argusro/Wearable_Datalogger/hardware/BOM_Wearable_ESP32-Pico.csv

ID | Name | Designator | Footprint | Quantity | Manufacturer Part | Manufacturer
1 | GPS1003 | ANT | ANT-SMD_L10.0-W3.0 | 1 | GPS1003 | Rainsun microwave Tech
2 | WF12502-01200 | BAT | CONN-SMD_2P-P1.25_L4.4-W7.5 | 1 | WF12502-01200 | SHENZHEN ATOM TECH
3 | 100nF | C1,C3,C4,C5,C8 | C0402 | 5 | CC0402KRX5R7BB104 | YAGEO
4 | 10uF | C2 | C0402 | 1 | CC0402MRX5R5BB106 | YAGEO
5 | 10uF | C6 | C0402 | 1 | 0402X105K100NT | FH
6 | 1uF | C7 | C0402 | 1 | 0402X105K100NT | FH
7 | 100nF | C9,C11 | C1206 | 2 | CC0402KRX5R7BB104 | YAGEO
8 | 80mF | C10 | CAP-TH_XH414HG | 1 | XH414HG-IV01E | SEIKO
9 | SD103CWS S6 | D1 | SOD-323_L1.8-W1.3-LS2.5-RD | 1 | SD103CWS S6 | CJ
10 | ESP32-PICO-V3 | ESP | LGA-48_L7.0-W7.0-P0.50-BL-EP5.0 | 1 | ESP32-PICO-V3 | ESPRESSIF
12 | 27uH | L1 | L0603 | 1 | SDFL1608T270KTF | Sunlord
13 | 19-213/R7C-AP1Q2L/3T | LED1 | LED0603-R-RD | 1 | 19-213/R7C-AP1Q2L/3T | Everlight Elec
14 | 19-217/G7C-BK2L2VY/3T | LED2,LED3 | LED0603-R-RD | 2 | 19-217/G7C-BK2L2VY/3T | Everlight Elec
15 | FS8205 | Q3 | SOT-23-6 | 1 | FS8205 | FORTUNE
16 | 10K | R1,R2,R9,R10,R11,R12,R13,R17,R18,R19,R20,R21,R24 | R0402 | 13 | RC0402JR-0710KL | YAGEO
17 | 1.2K | R3 | R0402 | 1 | CR0402-JW-122GLF | BOURNS
18 | 1K | R4 | R0402 | 1 | AC0402JR-071KL | YAGEO
19 | 100R | R5 | R0402 | 1 | AECR0402F100RK9 | ResistorToday
20 | 750K | R6 | R0402 | 1 | RC0402FR-07750KL | YAGEO
21 | 220K | R7 | R0402 | 1 | RMC0402220K1%N | Tyohm
22 | 33R | R8,R14,R15,R16 | R0402 | 4 | RC0402JR-0710KL | YAGEO
23 | 22R | R22 | R0402 | 1 | RC0402JR-0710KL | YAGEO
24 | 1K | R23 | R0402 | 1 | RC0402JR-0710KL | YAGEO
25 | 10k | R25,R26,R27,R28 | R0402 | 4 | RC0402JR-0710KL | YAGEO
26 | U.FL-R-SMT(10) | RF1 | ANT-SMD_UFL-R-SMT | 1 | U.FL-R-SMT(10) | Hirose
27 | sd | SD | TF-SMD_TF-012 | 1 | TF-CARD-ETF010811020008X | null
28 | TS342A2P-WZ | SW1 | SW-SMD_L4.0-W2.9-LS5.0 | 1 | TS342A2P-WZ | SHOU HAN
29 | BME280 | U2 | LGA-8_BME280 | 1 | BME280 | Bosch
30 | MPU-9250 | U3 | ICM-20948 | 1 | MPU-9250 | InvenSense
31 | TP4056 | U4 | ESOP-8_L4.9-W3.9-P1.27-LS6.0-BL-EP | 1 | TP4056 | TOPPOWER
32 | 24AA32A-I/SN | U5 | 24AA32A-I/SN | 1 | 24AA32A-I/MS | MICROCHIP
33 | MCP1700T-3302E/TT | U6,U8 | SOT-23-3_L2.9-W1.6-P1.90-LS2.8-BR | 2 | MCP1700T-3302E/TT | MICROCHIP
34 | DW01A_C351410 | U7 | SOT-23-6_L2.9-W1.6-P0.95-LS2.8-BL | 1 | DW01A | PUOLOP
35 | NEO-6M-GPS | U9 | GPS24P-SMD-1.1-16X12.2MM | 1 | NEO-6M-GPS
36 | MK15-B-2 | U11 | SENSOR-SMD_MK15-B-2 | 1 | MK15-B-2 | STANDEXMEDER
37 | FUS405-FSBK6M | USB | MICRO-USB-SMD_FUS405-FSBK6M | 1 | FUS405-FSBK6M | TXGA
