argusro/Wearable_Datalogger/hardware/Schematic_Wearable_ESP32-Pico.pdf

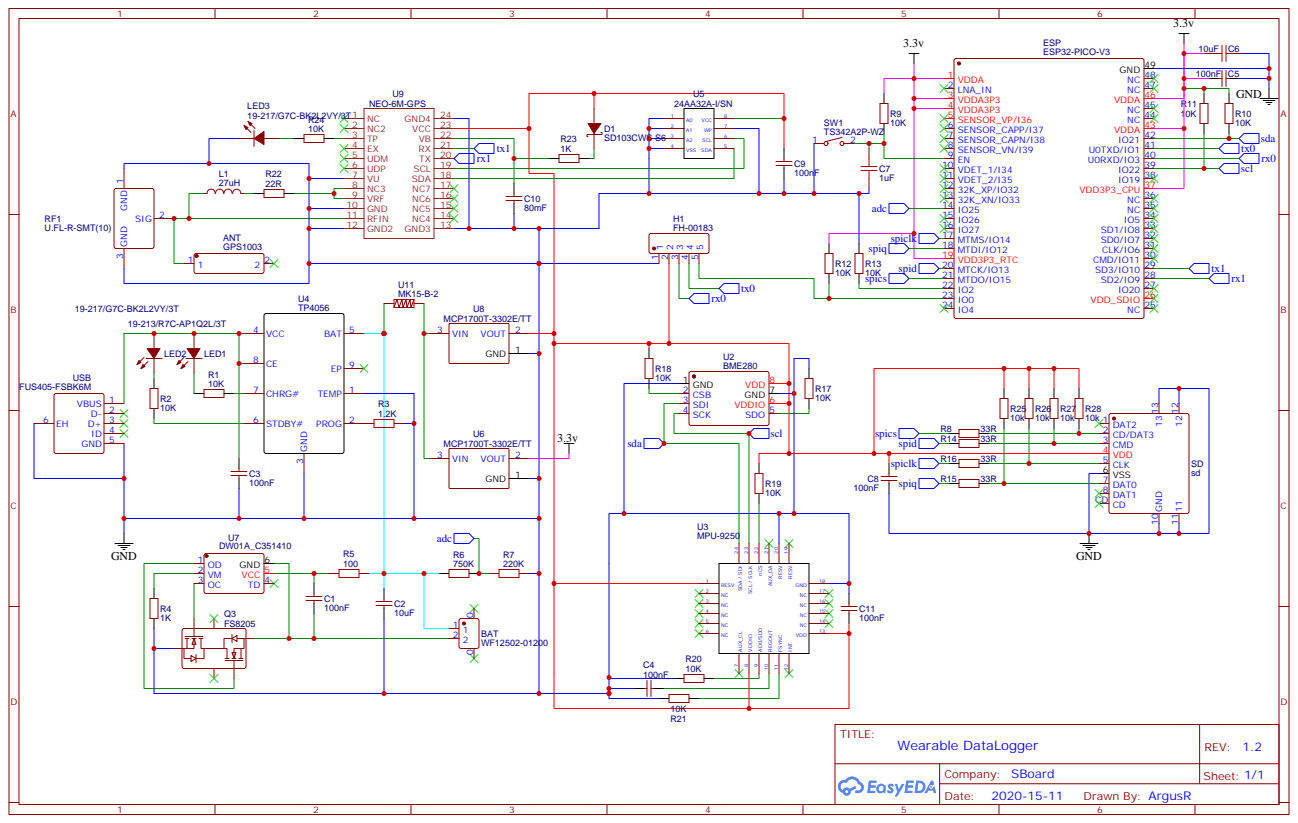
[picture p3: page 1]
